Les-Chopaings/carte-arduino/README.md

# cdfr2025-carte-Arduino
Arduino mega pro Shield for CDFR 2025
