Les-Chopaings/carte-arduino/carte actionneur2.step

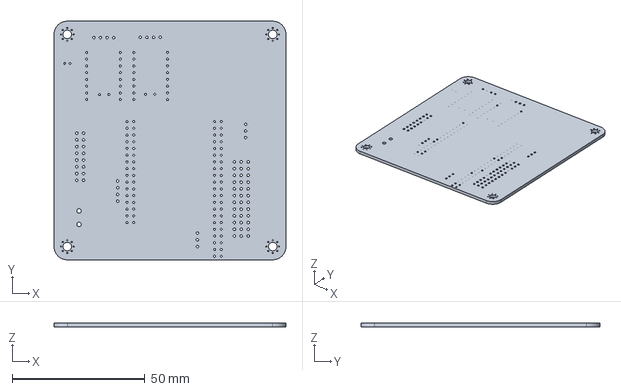
[picture p1: CAD file, 2025-11-15]
carte actionneur2.step
87.5 x 90.0 x 1.51 mm
