Les-Chopaings/carte-arduino/carte actionneur.kicad_pcb

## KiCad design carte actionneur.kicad_pcb (2025-11-16)

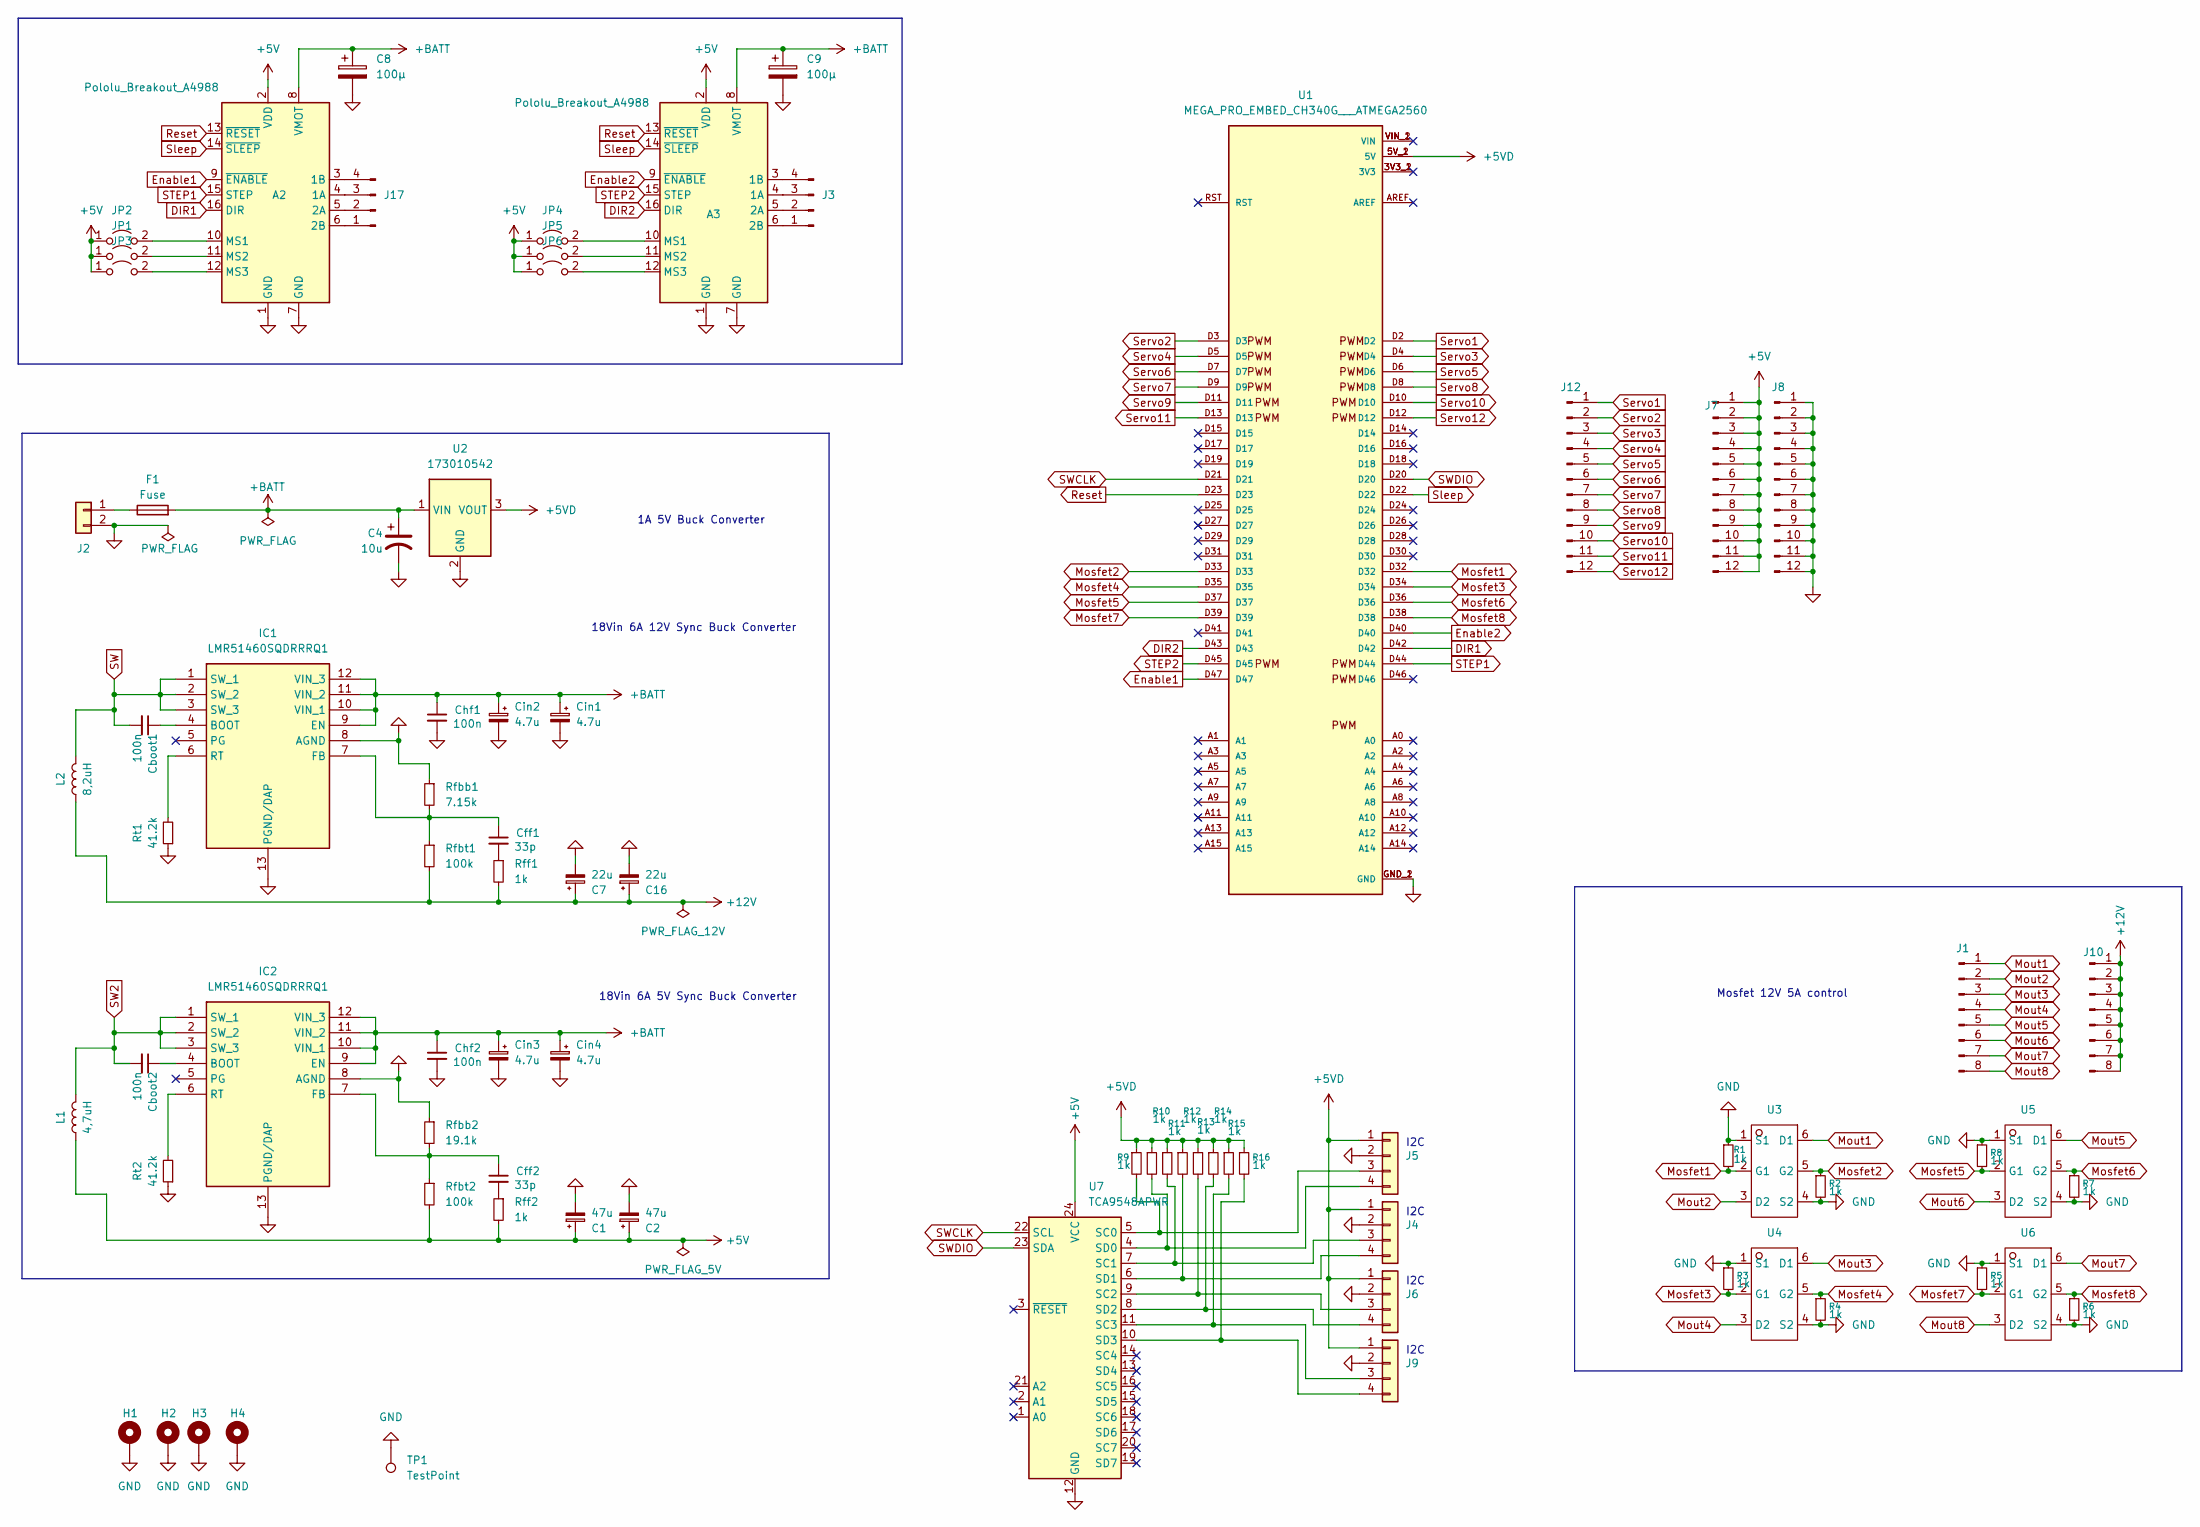
[picture p2: schematic carte actionneur.kicad_sch]

Parts:
A2, A3: Pololu_Breakout_A4988; Pololu_Breakout-16_15.2x20.3mm
C1, C2: 47u; C_1206_3216Metric
C4: 10u; C_1206_3216Metric
C7, C16: 22u; C_1206_3216Metric
C8, C9: 100µ; CP_Radial_D8.0mm_P3.50mm
Cboot1, Cboot2: 100n; C_1206_3216Metric
Cff1, Cff2: 33p; C_1206_3216Metric
Chf1, Chf2: 100n; C_1206_3216Metric
Cin1, Cin2, Cin3, Cin4: 4.7u; C_1206_3216Metric
F1: Fuse; Fuseholder_Cylinder-5x20mm_EATON_H15-V-1_Vertical_Closed
H1, H2, H3, H4: MountingHole_Pad; MountingHole_3.2mm_M3_Pad_Via
IC1, IC2: LMR51460SQDRRRQ1; SON50P300X300X80-13N-D; Manufacturer_Part_Number LMR51460SQDRRRQ1
J1, J10: Conn_01x08_Pin; PinHeader_1x08_P2.54mm_Vertical
J2: Conn_01x02; CUI_TBP01R1-508-02BE
J3, J17: Conn_01x04_Pin; JST_XH_B4B-XH-A_1x04_P2.50mm_Vertical
J4, J5, J6, J9: Conn_01x03; PinHeader_1x04_P2.54mm_Vertical
J7, J8, J12: Conn_01x12_Pin; PinHeader_1x12_P2.54mm_Vertical
JP1, JP2, JP3, JP4, JP5, JP6: Jumper_2_Open; SolderJumper-2_P1.3mm_Open_TrianglePad1.0x1.5mm
L1: 4,7uH; INDPM7168X300N
L2: 8,2uH; INDPM7168X300N
R1, R2, R3, R4, R5, R6, R7, R8, R9, R10, R11, R12, R13, R14, R15, R16: 1k; R_1206_3216Metric
Rfbb1: 7.15k; R_1206_3216Metric
Rfbb2: 19.1k; R_1206_3216Metric
Rfbt1, Rfbt2: 100k; R_1206_3216Metric
Rff1, Rff2: 1k; R_1206_3216Metric
Rt1, Rt2: 41.2k; R_1206_3216Metric
TP1: TestPoint; TestPoint_Bridge_Pitch2.0mm_Drill0.7mm
U1: MEGA_PRO_EMBED_CH340G___ATMEGA2560; MODULE_MEGA_PRO_2_CONNECTOR; PARTREV 12/May/2017
U2: 173010542; U_Wurth_MagIC-FDSM_173010x42
U3, U4, U5, U6: TSOP-6_1.65x3.05mm_P0.95mm
U7: TCA9548APWR; ADA Perso

Connections:
+5V: A2.2 (VDD), A3.2 (VDD), C1.1, C2.1, J7.1, J7.2, J7.3, J7.4, J7.5, J7.6, J7.7, J7.8, J7.9, J7.10, J7.11, J7.12, JP1.1 (A), JP2.1 (A), JP3.1 (A), JP4.1 (A), JP5.1 (A), JP6.1 (A), L1.2, Rfbt2.2, Rff2.2, U7.24 (VCC)
+5VD: J4.1, J5.1, J6.1, J9.1, R9.1, R10.1, R11.1, R12.1, R13.1, R14.1, R15.1, R16.1, U1.5V_1 (5V), U1.5V_2 (5V), U2.3 (VOUT)
+12V: C7.1, C16.1, J10.1, J10.2, J10.3, J10.4, J10.5, J10.6, J10.7, J10.8, L2.2, Rfbt1.2, Rff1.2
+BATT: A2.8 (VMOT), A3.8 (VMOT), C4.1, C8.1, C9.1, Chf1.1, Chf2.1, Cin1.1, Cin2.1, Cin3.1, Cin4.1, F1.2, IC1.9 (EN), IC1.10 (VIN_1), IC1.11 (VIN_2), IC1.12 (VIN_3), IC2.9 (EN), IC2.10 (VIN_1), IC2.11 (VIN_2), IC2.12 (VIN_3), U2.1 (VIN)
DIR1: A2.16 (DIR), U1.D42
DIR2: A3.16 (DIR), U1.D43
Enable1: A2.9 (~ENABLE), U1.D47
Enable2: A3.9 (~ENABLE), U1.D40
GND: A2.1 (GND), A2.7 (GND), A3.1 (GND), A3.7 (GND), C1.2, C2.2, C4.2, C7.2, C8.2, C9.2, C16.2, Chf1.2, Chf2.2, Cin1.2, Cin2.2, Cin3.2, Cin4.2, H1.1, H2.1, H3.1, H4.1, IC1.8 (AGND), IC1.13 (PGND/DAP), IC2.8 (AGND), IC2.13 (PGND/DAP), J2.2, J4.2, J5.2, J6.2, J8.1, J8.2, J8.3, J8.4, J8.5, J8.6, J8.7, J8.8, J8.9, J8.10, J8.11, J8.12, J9.2, R1.1, R2.2, R3.1, R4.2, R5.1, R6.2, R7.2, R8.1, Rfbb1.1, Rfbb2.1, Rt1.1, Rt2.1, TP1.1, U1.GND_1 (GND), U1.GND_2 (GND), U2.2 (GND), U3.1 (S1), U3.4 (S2), U4.1 (S1), U4.4 (S2), U5.1 (S1), U5.4 (S2), U6.1 (S1), U6.4 (S2), U7.12 (GND)
Mosfet1: R1.2, U1.D32, U3.2 (G1)
Mosfet2: R2.1, U1.D33, U3.5 (G2)
Mosfet3: R3.2, U1.D34, U4.2 (G1)
Mosfet4: R4.1, U1.D35, U4.5 (G2)
Mosfet5: R8.2, U1.D37, U5.2 (G1)
Mosfet6: R7.1, U1.D36, U5.5 (G2)
Mosfet7: R5.2, U1.D39, U6.2 (G1)
Mosfet8: R6.1, U1.D38, U6.5 (G2)
Mout1: J1.1, U3.6 (D1)
Mout2: J1.2, U3.3 (D2)
Mout3: J1.3, U4.6 (D1)
Mout4: J1.4, U4.3 (D2)
Mout5: J1.5, U5.6 (D1)
Mout6: J1.6, U5.3 (D2)
Mout7: J1.7, U6.6 (D1)
Mout8: J1.8, U6.3 (D2)
unnamed: A2.4 (1A), J17.3
unnamed: A2.3 (1B), J17.4
unnamed: A2.5 (2A), J17.2
unnamed: A2.6 (2B), J17.1
unnamed: A2.10 (MS1), JP2.2 (B)
unnamed: A2.11 (MS2), JP1.2 (B)
unnamed: A2.12 (MS3), JP3.2 (B)
unnamed: A3.4 (1A), J3.3
unnamed: A3.3 (1B), J3.4
unnamed: A3.5 (2A), J3.2
unnamed: A3.6 (2B), J3.1
unnamed: A3.10 (MS1), JP4.2 (B)
unnamed: A3.11 (MS2), JP5.2 (B)
unnamed: A3.12 (MS3), JP6.2 (B)
unnamed: Cff1.2, Rff1.1
unnamed: Cff2.2, Rff2.1
unnamed: Cboot1.1, IC1.4 (BOOT)
unnamed: Cff1.1, IC1.7 (FB), Rfbb1.2, Rfbt1.1
unnamed: IC1.6 (RT), Rt1.2
unnamed: Cboot2.1, IC2.4 (BOOT)
unnamed: Cff2.1, IC2.7 (FB), Rfbb2.2, Rfbt2.1
unnamed: IC2.6 (RT), Rt2.2
unnamed: F1.1, J2.1
unnamed: J4.3, R11.2, U7.7 (SC1)
unnamed: J4.4, R12.2, U7.6 (SD1)
unnamed: J5.3, R9.2, U7.5 (SC0)
unnamed: J5.4, R10.2, U7.4 (SD0)
unnamed: J6.3, R13.2, U7.9 (SC2)
unnamed: J6.4, R14.2, U7.8 (SD2)
unnamed: J9.3, R15.2, U7.11 (SC3)
unnamed: J9.4, R16.2, U7.10 (SD3)
Reset: A2.13 (~RESET), A3.13 (~RESET), U1.D23
STEP1: A2.15 (STEP), U1.D44
STEP2: A3.15 (STEP), U1.D45
SW: Cboot1.2, IC1.1 (SW_1), IC1.2 (SW_2), IC1.3 (SW_3), L2.1
SW2: Cboot2.2, IC2.1 (SW_1), IC2.2 (SW_2), IC2.3 (SW_3), L1.1
SWCLK: U1.D21, U7.22 (SCL)
SWDIO: U1.D20, U7.23 (SDA)
Servo1: J12.1, U1.D2
Servo2: J12.2, U1.D3
Servo3: J12.3, U1.D4
Servo4: J12.4, U1.D5
Servo5: J12.5, U1.D6
Servo6: J12.6, U1.D7
Servo7: J12.7, U1.D9
Servo8: J12.8, U1.D8
Servo9: J12.9, U1.D11
Servo10: J12.10, U1.D10
Servo11: J12.11, U1.D13
Servo12: J12.12, U1.D12
Sleep: A2.14 (~SLEEP), A3.14 (~SLEEP), U1.D22

Notes on the sheet:
18Vin 6A 5V Sync Buck Converter
Mosfet 12V 5A control
18Vin 6A 12V Sync Buck Converter
I2C
1A 5V Buck Converter

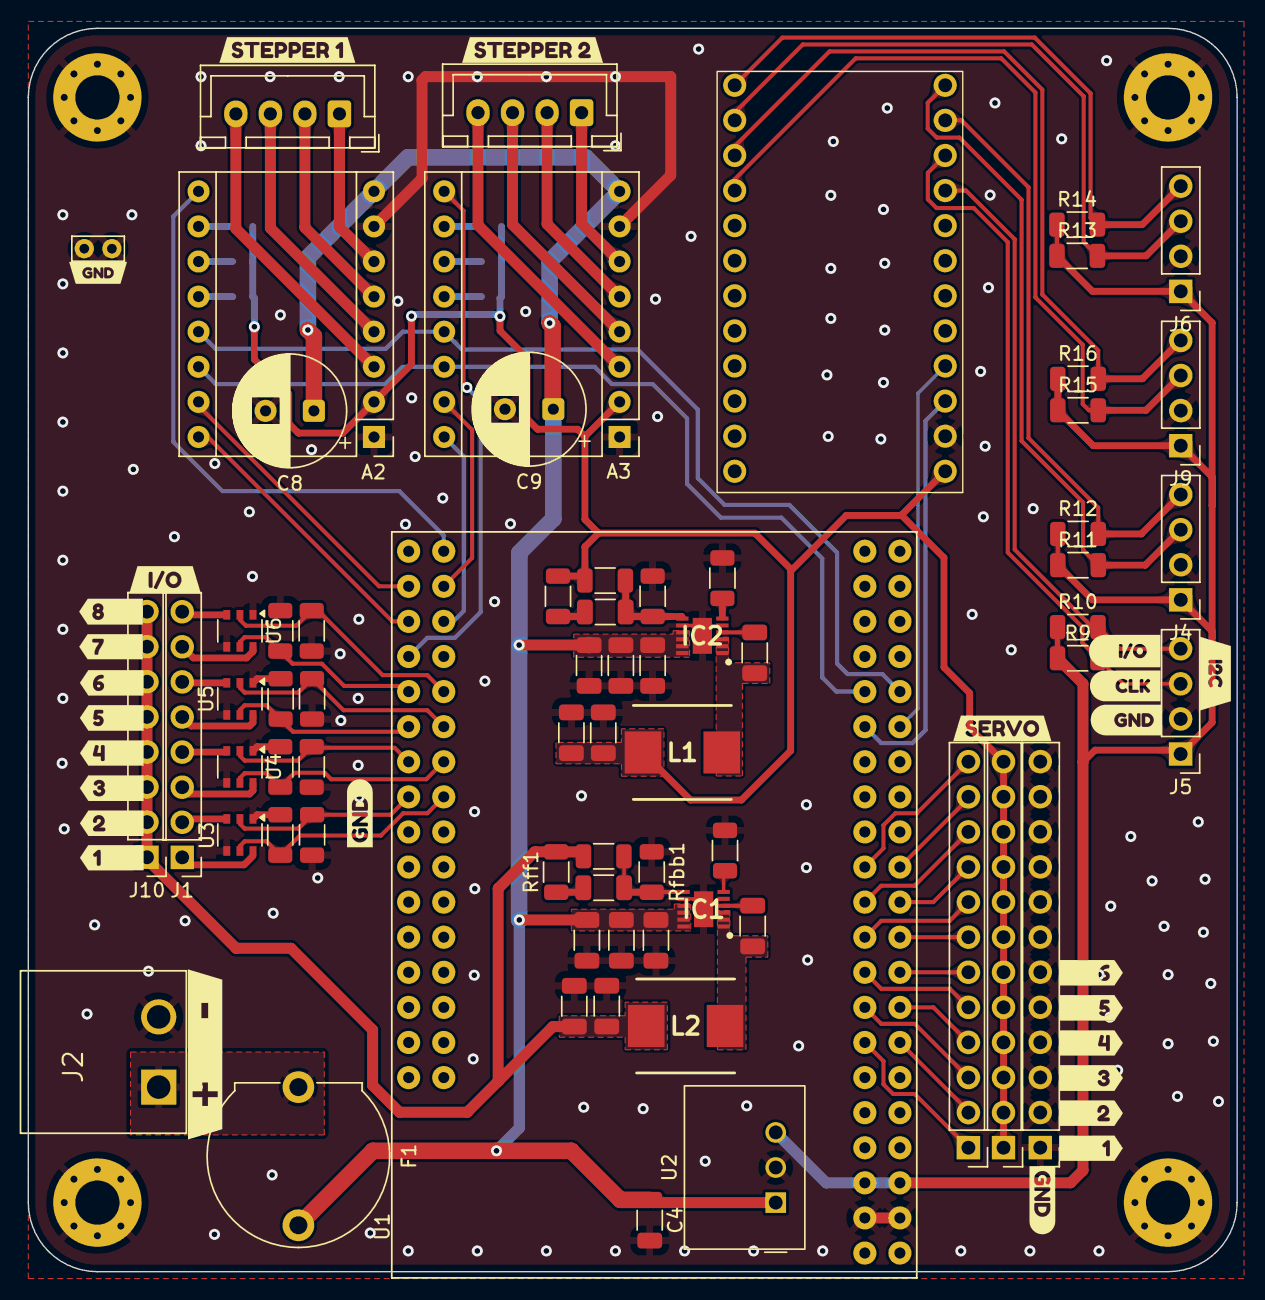
[picture p3: board carte actionneur.kicad_pcb from above]

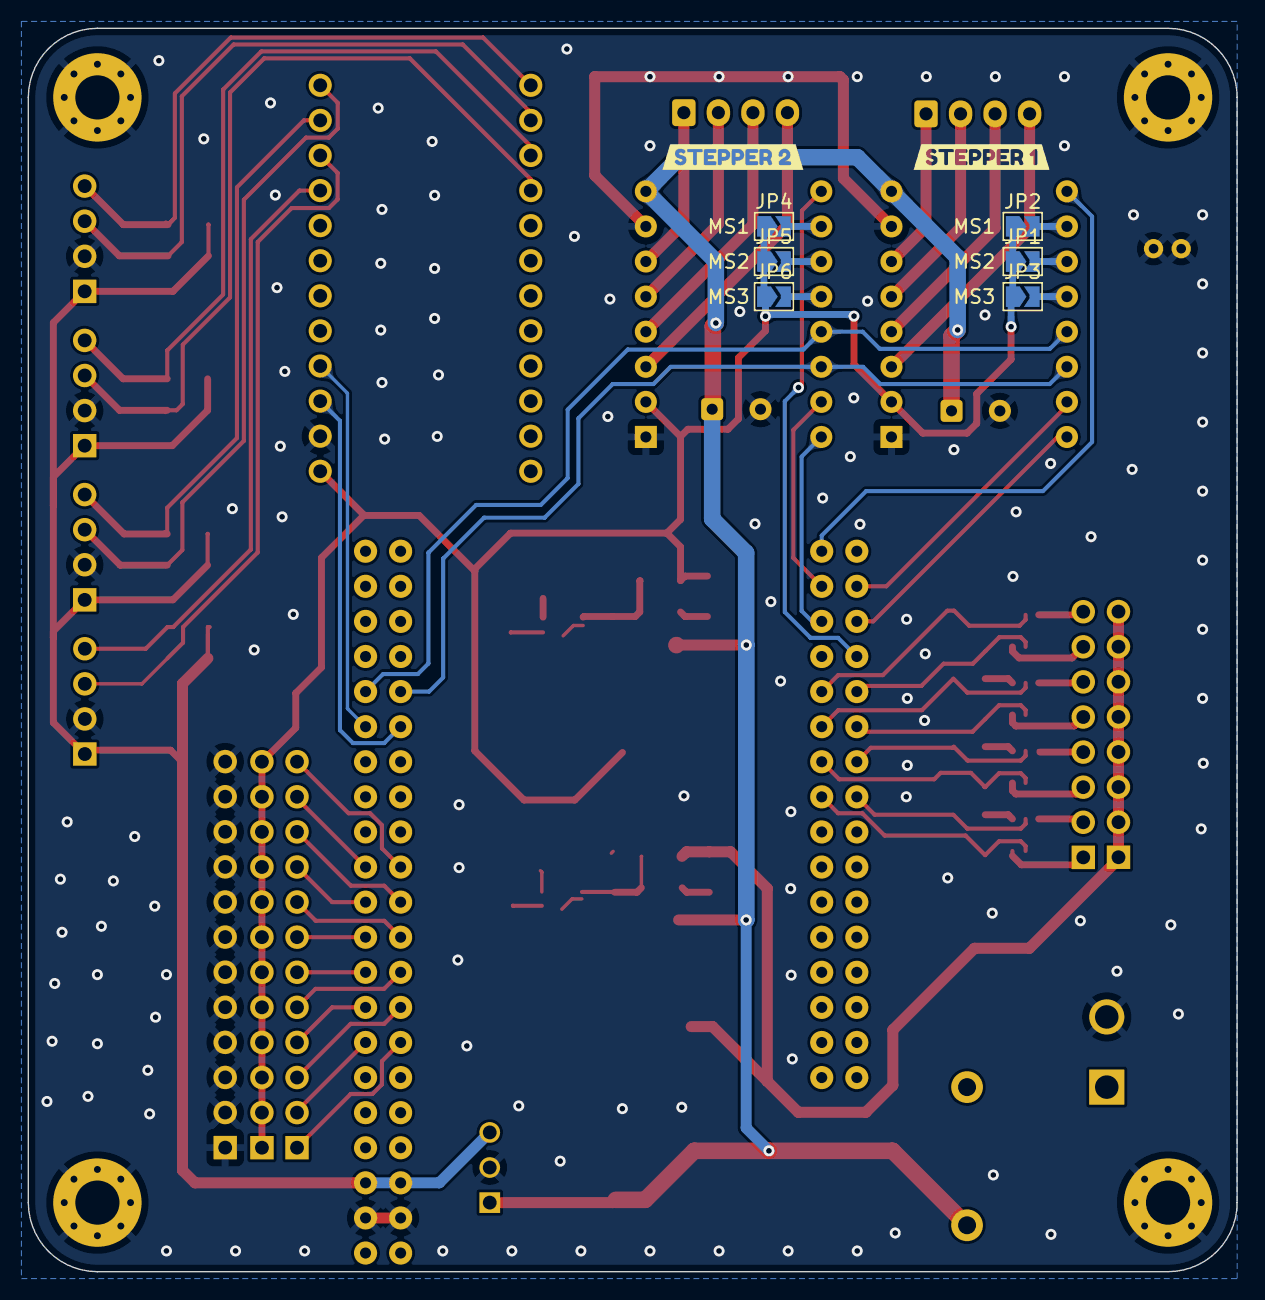
[picture p4: board carte actionneur.kicad_pcb from below]

Board: 2 copper layers, 87.5 x 90.0 mm, 106 parts (8 on the bottom side), 76 nets.

Other parts of the board:
kibuzzard-67A0F0A3: G***; kibuzzard-67A0F0A3
kibuzzard-67A0F0D2: G***; kibuzzard-67A0F0D2
kibuzzard-67A0F0E8: G***; kibuzzard-67A0F0E8
kibuzzard-67A0F0EE: G***; kibuzzard-67A0F0EE
kibuzzard-67A13B87: G***; kibuzzard-67A13B87
kibuzzard-67A14542: G***; kibuzzard-67A14542
kibuzzard-679EA1D9: G***; kibuzzard-679EA1D9
kibuzzard-679EA1F0: G***; kibuzzard-679EA1F0
kibuzzard-679EA1FA: G***; kibuzzard-679EA1FA
kibuzzard-679EA20F: G***; kibuzzard-679EA20F
kibuzzard-679EA25C: G***; kibuzzard-679EA25C
kibuzzard-679EA204: G***; kibuzzard-679EA204
kibuzzard-679EA208: G***; kibuzzard-679EA208
kibuzzard-679EA236, kibuzzard-679EA236#2: G***; kibuzzard-679EA236
kibuzzard-679FD2F5: G***; kibuzzard-679FD2F5
kibuzzard-679FD63B: G***; kibuzzard-679FD63B
kibuzzard-679FD63E: G***; kibuzzard-679FD63E
kibuzzard-679FD64B: G***; kibuzzard-679FD64B
kibuzzard-679FD326: G***; kibuzzard-679FD326
kibuzzard-679FD606: G***; kibuzzard-679FD606
kibuzzard-679FD637: G***; kibuzzard-679FD637
kibuzzard-679FD642: G***; kibuzzard-679FD642
kibuzzard-679FD645: G***; kibuzzard-679FD645
kibuzzard-679FD648: G***; kibuzzard-679FD648
kibuzzard-679FD690: G***; kibuzzard-679FD690
kibuzzard-679FDC70: G***; kibuzzard-679FDC70
kibuzzard-679FDCB9: G***; kibuzzard-679FDCB9
