Les-Chopaings/carte-arduino/(commit log)

2025-10-14 - Added 3 servo pin, for a total of 12 // - Modified pin assignment to connect to proper PWM arduino pins // - Added pull-down resistors to mosfets // - Deleted PWM lidar pin // - Modified inductor c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
    [carte actionneur.kicad_pcb, carte actionneur.kicad_sch]
2025-11-11 Added TCA9548A module for I2C multiplexing
    [carte actionneur.kicad_pcb, carte actionneur.kicad_sch]
2025-11-11 Modified pins and added 5V to I2C
    [carte actionneur.kicad_pcb, carte actionneur.kicad_sch]
2025-11-15 fix warning pcb
    [carte actionneur.kicad_pcb, carte actionneur.kicad_sch, carte actionneur2.step]
2025-11-16 Modified fuse holder footprint
    [carte actionneur.kicad_pcb, carte actionneur.kicad_sch]
